justinmulhall13/Quadruped-Walker-Gordo-/mechanical/onshape_link.md

# Final Onshape CAD

[Robot Assembly](https://cad.onshape.com/documents/e473a6d85d236854e9853a61/w/fd848eed1485c83b68666b8f/e/1c2c3b7d007a87cbbf54fd64)

## Final Assembly
- 4 legs, 2 DOF each
- 8x DS3218 servo mounts
- Chassis designed to house ESP32-S3 Freenove and PCA9685 board
