justinmulhall13/Quadruped-Walker-Gordo-/(commit log)

2026-05-19 Add assembled build photo, KiCad wiring schematic, updated README — hardware assembly complete, awaiting power supply parts
2026-05-19 Switch build photo to PNG for GitHub inline rendering
2026-05-19 Update README — servos calibrated, web controller complete, power wiring pending
2026-07-30 Add first walking prototype video — rough gait, feet still in progress
    Gordo walks untethered off the 2S LiPo for the first time. Motion is a slow
    shuffle, not a clean trot: swing/stance phases overlap, lift height is too low
    so the legs scuff, and the legs still end in bare printed shanks with no feet,
    which slide on carpet.
    - Add media/gordo_walk_prototype.mp4 (full clip) and .gif (inline preview)
    - README: new walking-prototype section documenting what is wrong and why
    - README: status updated — power wiring and PCA9685 init done, gait engine and
    foot design explicitly marked as still prototyping
    - README: fix escaped backticks that broke the file-structure code block
    Co-Authored-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
2026-07-30 Correct power architecture — no buck converters, LiPo direct to breakout
    The twin-buck plan in the docs was never built. The 2S LiPo is spliced and
    soldered straight to the Freenove breakout's power port and the board's onboard
    regulator does the conversion; PCA9685 V+ is fed from the breakout's 5V pin.
    Also flags the consequence: all 8 DS3218 draw through a regulator sized for
    logic, so the servo rail is current-starved. That is the leading suspect for the
    weak gait in the walking clip — sluggish, low-torque legs that will not lift
    clear of the carpet — with DS3218 running at 5V instead of its rated 6.8V on
    top of it.
    - README, docs/notes.md, hardware/wiring_diagram.md: power sectio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
2026-07-30 Drop the current-starvation claim — servos drive fine off the breakout rail
    Previous commit asserted the servo rail was current-starved and called it the
    likely cause of the weak gait. That was inference from the video, not
    observation of the hardware. The servos run fine and none of them stall, so the
    claim is removed from the README, notes and wiring doc.
    Remaining gait issues stand as documented: phase timing, lift height, no feet,
    and body attitude.
2026-08-21 Gordo: firmware, gait, and build writeup
    First public state of the quadruped: ESP32-S3 + PCA9685 + 8x DS3218,
    two DOF per leg. servo_tuner is the live-tunable firmware and the one
    that produced the walk in the video; quadruped and center_hold are the
    earlier scripted-pose and neutral-hold sketches.
